547grbluser/FPGA-DENDY/PCB/Cyclone PCB/FPGA_DENDY.png

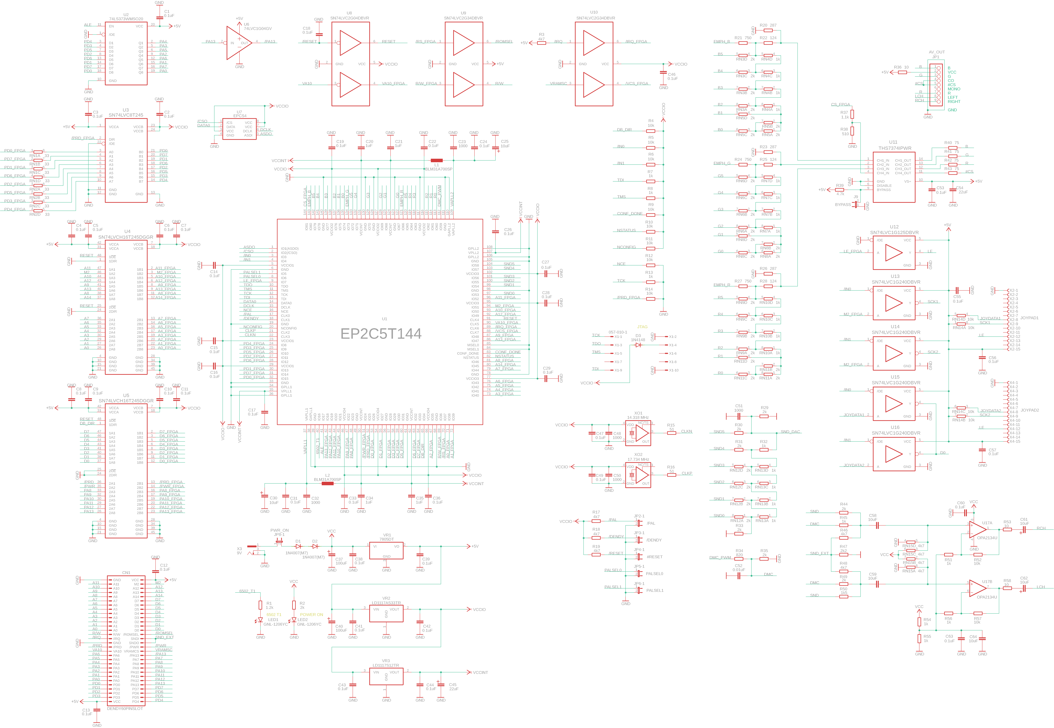
PCB/Cyclone PCB/FPGA_DENDY.png
