547grbluser/FPGA-DENDY/PCB/Lattice PCB/FPGA_DENDY_LAT.png

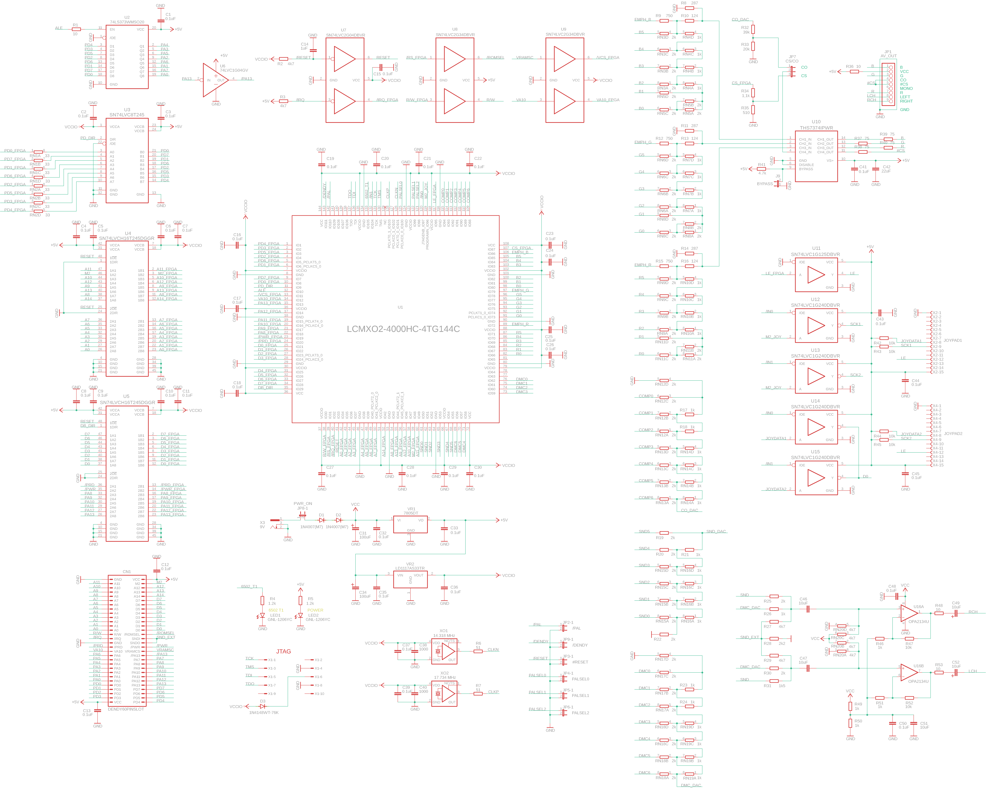
PCB/Lattice PCB/FPGA_DENDY_LAT.png
