547grbluser/FPGA-DENDY/PCB/Lattice PCB/BOM FPGA_DENDY LAT.xlsx

POS | Q-ty | VALUE | manufacturer | package | PART NUM | SIMILAR
 | 1 | LCMXO2-4000HC-4TG144I | Lattice Semiconductor | TQFP-144 | LCMXO2-4000HC-4TG144I | LCMXO2-4000HC-4TG144C
 | 1 | SN74LVC8T245PWR | TI | TSSOP-24 | SN74LVC8T245PWR | SN74LVC4245APWR
 | 2 | SN74LVCH16T245DGGR | TI | TSSOP-48 | SN74LVCH16T245DGGR
 | 1 | SN74LS373DW | TI | soic-20(7.5мм) | SN74LS373DW
 | 4 | SN74LVC1G240DBVR | TI | SOT-23-5 | SN74LVC1G240DBVR
 | 1 | SN74LVC1G125DBVR | TI | SOT-23-5 | SN74LVC1G125DBVR
 | 1 | SN74LVC1G04DBVR | TI | SOT-23-5 | SN74LVC1G04DBVR
 | 1 | SN74LVC2G04DBVR | TI | SOT-23-6 | SN74LVC2G04DBVR
 | 2 | SN74LVC2G34DBVR | TI | SOT-23-6 | SN74LVC2G34DBVR
 | 1 | BA4558F-E2 | Rohm | SOP-8 | BA4558F-E2
 | 1 | THS7374IPWR | TI | TSSOP-14 | THS7374IPWR
 | 1 | UMW 78M05 | UMW | DPAK/TO-252 | UMW 78M05
 | 1 | LD1117AS33TR | STM | SOT-223 | LD1117AS33TR
 | 1 | crystal oscillator 14.318MHz |  | 7050
 | 1 | crystal oscillator 17.734MHz |  | 7050
 | 2 | SMA4007 | UMW | DO-214AC/SMA | 1N4007(M7)
 | 1 | 1N4148W | EVVOSEMI | SOD - 123 | 1N4148W
 | 1 | GNL-1206YC | G-nor Electronics | 1206 | GNL-1206YC | any 1206 SMD LED (YELLOW)
 | 6 | 4х1kΩ1% | Bourns | 0603x4 | CAT16-102J4LF
 | 11 | 4х2kΩ1% | Bourns | 0603x4 | CAT16-202J4LF
 | 2 | 4х22Ω1% | Bourns | 0603x4 | CAT16-22R0F4LF
 | 1 | 4х4k7kΩ5% | Bourns | 0603x4 | CAT16-472J4LF
 | 4 | 75Ω±5% | YAGEO | 0603 | RC0603JR-0775RL
 | 2 | 51Ω±5% | YAGEO | 0603 | RC0603JR-0751RL
 | 4 | 10Ω±5% | YAGEO | 0603 | RC0603JR-0710RL
 | 2 | 1,2kΩ±5% | YAGEO | 0603 | RC0603JR-071K2L
 | 1 | 1,1kΩ±1% | YAGEO | 0603 | RC0603FR-071K1L
 | 1 | 510Ω±1% | YAGEO | 0603 | RC0603FR-07510RL
 | 3 | 750Ω±1% | KOA Speer | 0603 | RK73H1JTTD7500F
 | 9 | 1kΩ±1% | KOA Speer | 0603 | RK73G1JTTD1001F
 | 3 | 2kΩ±1% | KOA Speer | 0603 | RK73G1JTTD2001F
 | 1 | 20kΩ±1% | KOA Speer | 0603 | RK73H1JTTD2002F
 | 1 | 39kΩ±1% | KOA Speer | 0603 | RK73H1JTTD3902F
 | 6 | 4,7kΩ±5% | YAGEO | 0603 | RC0603JR-074K7L
 | 4 | 10kΩ±5% | YAGEO | 0603 | RC0603JR-0710KL
 | 3 | 124Ω±1% | Vishay/Dale | 0603 | CRCW0603124RFKEA
 | 3 | 287Ω±1% | KOA Speer | 0603 | RK73H1JTTD2870F
 | 41 | 0.1uF X7R 16V 10% | Murata | 0603 | GRM188R71C104KA01D
 | 2 | 1000pF NP0 50V 5% 0603 | Murata | 0603 | GRM1885C1H102J
 | 8 | 10uF X7R 10% 25V 1210, | Murata | 1210 | GRM32DR71E106KA12L
 | 2 | 100uF, 16v, 105°C, 20% ECAP SMD, 6.3x5.4мм, | JB cap | 6.3x5.4 | JCK1C101M063054
 | 1 | 9 Pin Mini DIN Female PCB Panel Mount | China
 | 1 | BH-10 (DS1013-10S) (IDC-10MS) | CONNFLY | 2*5*2.54 | DS1013-10SSiB1-B-0
 | 1 | KLS1-DC-005A-2.0 | KLS electronic co ltd | 2,1х5.5x9mm | L-KLS1-DC-005A-2.0
