547grbluser/FPGA-DENDY/PCB/Lattice PCB/FPGA_DENDY_LAT.sch

## EAGLE design PCB/Lattice PCB/FPGA_DENDY_LAT.sch (2026-10-07)

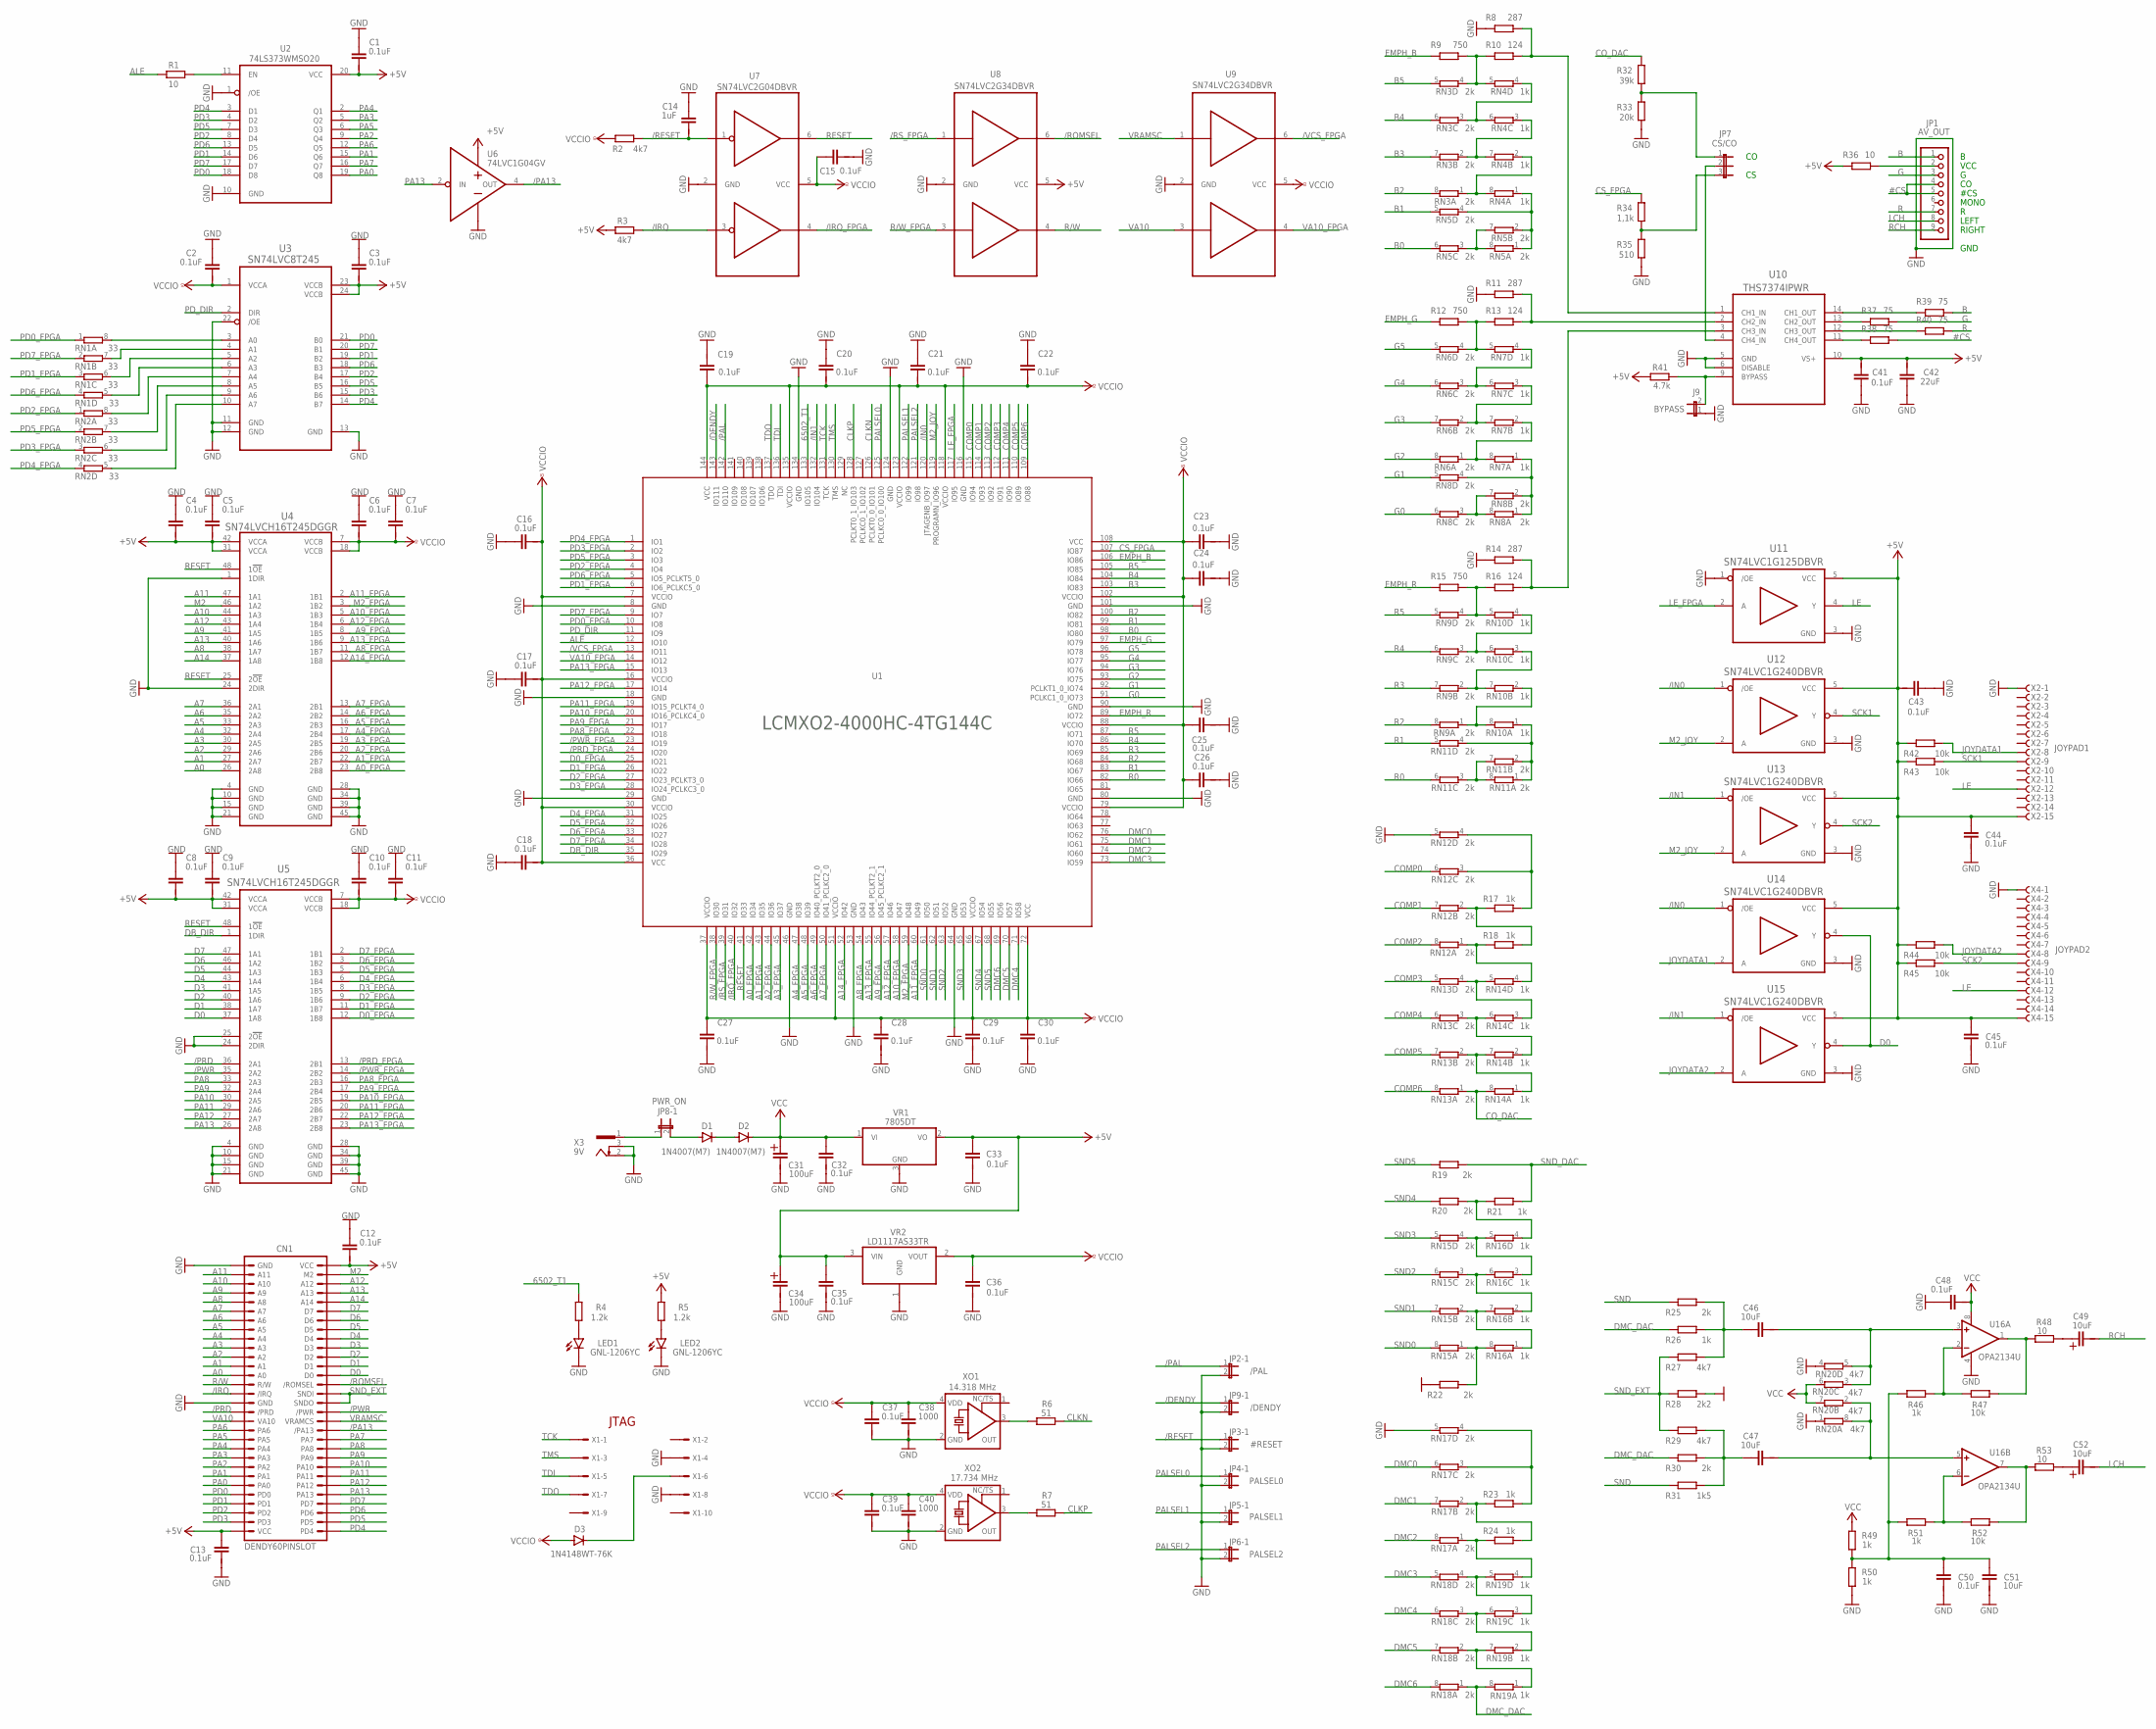
[picture p5: schematic FPGA_DENDY_LAT.sch]

Parts:
C1, C2, C3, C4, C5, C6, C7, C8, C9, C10, C11, C12, C13, C15, C16, C17, C18, C19, C20, C21, C22, C23, C24, C25, C26, C27, C28, C29, C30, C32, C33, C35, C36, C37, C39, C44, C45, C48, C50: 0.1uF; C0805
C14: 1uF; C0805
C31, C34: 100uF; 153CLV-0505
C38, C40: 1000; C0805
C41, C43: 0.1uF; C0603
C42: 22uF; C0603
C46, C47, C51: 10uF; C0805
C49, C52: 10uF; 153CLV-0505
CN1: DENDY60PINSLOT; 60PINDENDY
D1, D2: 1N4007(M7); DO-214AC
D3: 1N4148WT-76K; DO214AA
J9: BYPASS; JP1
JP1: AV_OUT; 1X09
JP2: /PAL; JP4Q
JP3: #RESET; JP4Q
JP4: PALSEL0; JP4Q
JP5: PALSEL1; JP4Q
JP6: PALSEL2; JP4Q
JP7: CS/CO; JP2W
JP8: PWR_ON; JP4Q
JP9: /DENDY; JP4Q
LED1, LED2: GNL-1206YC; SML1206
R1, R36, R48, R53: 10; R0805
R2, R3, R27, R29: 4k7; R0805
R4, R5: 1.2k; R0805
R6, R7: 51; R0805
R8, R11, R14: 287; R0805
R9, R12, R15: 750; R0805
R10, R13, R16: 124; R0805
R17, R18, R21, R23, R24, R26, R46, R49, R50, R51: 1k; R0805
R19, R20, R22, R25, R30: 2k; R0805
R28: 2k2; R0805
R31: 1k5; R0805
R32: 39k; R0805
R33: 20k; R0805
R34: 1,1k; R0805
R35: 510; R0805
R37, R38, R39, R40: 75; R0805
R41: 4.7k; R0805
R42, R43, R44, R45, R47, R52: 10k; R0805
RN1, RN2: 33; 0603-ARC
RN3, RN5, RN6, RN8, RN9, RN11, RN12, RN13, RN15, RN17, RN18: 2k; 0603-ARC
RN4, RN7, RN10, RN14, RN16, RN19: 1k; 0603-ARC
RN20: 4k7; 0603-ARC
U1: LCMXO2-4000HC-4TG144C; TQFP144
U2: 74LS373WMSO20; SO20W
U3: SN74LVC8T245; SOP65P640X110-24N
U4, U5: SN74LVCH16T245DGGR; SOP50P810X120-48N
U6: 74LVC1G04GV; SOT95P275X110-5N
U7: SN74LVC2G04DBVR; SOT-23-6
U8, U9: SN74LVC2G34DBVR; SOT-23-6
U10: THS7374IPWR; SOP65P640X120-14N
U11: SN74LVC1G125DBVR; SOT95P280X145-5N
U12, U13, U14, U15: SN74LVC1G240DBVR; SOT95P280X145-5N
U16: OPA2134U; SO08
VR1: 7805DT; TO252
VR2: LD1117AS33TR; SOT230P700X180-4N
X1: 057-010-1
X2: JOYPAD1; F15HP
X3: 9V; 733980-62
X4: JOYPAD2; F15HP
XO1: 14.318 MHz; 7.0X5.08_KXO-(V)97
XO2: 17.734 MHz; 2.5X2.0_KXO-V95

Connections:
6502_T1: R4.2, U1.133 (IO105)
#CS: JP1.4, JP1.5, R38.2
+5V: C1.2, C3.2, C4.2, C5.2, C8.2, C9.2, C12.2, C13.1, C33.1, C34.+, C35.1, C41.2, C42.2, C43.2, C44.1, C45.1, CN1.A30 (VCC), CN1.B1 (VCC), R3.1, R5.2, R36.1, R41.1, R42.1, R43.1, R44.1, R45.1, U2.20 (VCC), U3.23 (VCCB), U3.24 (VCCB), U4.31 (VCCA), U4.42 (VCCA), U5.31 (VCCA), U5.42 (VCCA), U6.5 (VCC), U8.5 (VCC), U10.10 (VS+), U11.5 (VCC), U12.5 (VCC), U13.5 (VCC), U14.5 (VCC), U15.5 (VCC), VR1.2 (VO), VR2.3 (VIN), X2.15 (F), X4.15 (F)
/DENDY: JP9.1, U1.143 (IO111)
/IN0: U1.120 (JTAGENB_IO97), U12.1 (/OE), U14.1 (/OE)
/IN1: U1.132 (IO104), U13.1 (/OE), U15.1 (/OE)
/IRQ: CN1.A15 (/IRQ), R3.2, U7.3 (IN2)
/IRQ_FPGA: U1.40 (IO32), U7.4 (OUT2)
/PA13: CN1.B19 (/PA13), U6.4 (OUT)
/PAL: JP2.1, U1.142 (IO110)
/PRD: CN1.A17 (/PRD), U5.36 (2A1)
/PRD_FPGA: U1.24 (IO20), U5.13 (2B1)
/PWR: CN1.B17 (/PWR), U5.35 (2A2)
/PWR_FPGA: U1.23 (IO19), U5.14 (2B2)
/RESET: C14.2, JP3.1, R2.2, U7.1 (IN1)
/ROMSEL: CN1.B14 (/ROMSEL), U8.6 (OUT1)
/RS_FPGA: U1.39 (IO31), U8.1 (IN1)
/VCS_FPGA: U1.13 (IO11), U9.6 (OUT1)
A0: CN1.A13 (A0), U4.26 (2A8)
A0_FPGA: U1.42 (IO34), U4.23 (2B8)
A1: CN1.A12 (A1), U4.27 (2A7)
A1_FPGA: U1.43 (IO35), U4.22 (2B7)
A2: CN1.A11 (A2), U4.29 (2A6)
A2_FPGA: U1.44 (IO36), U4.20 (2B6)
A3: CN1.A10 (A3), U4.30 (2A5)
A3_FPGA: U1.45 (IO37), U4.19 (2B5)
A4: CN1.A9 (A4), U4.32 (2A4)
A4_FPGA: U1.47 (IO38), U4.17 (2B4)
A5: CN1.A8 (A5), U4.33 (2A3)
A5_FPGA: U1.48 (IO39), U4.16 (2B3)
A6: CN1.A7 (A6), U4.35 (2A2)
A6_FPGA: U1.49 (IO40_PCLKT2_0), U4.14 (2B2)
A7: CN1.A6 (A7), U4.36 (2A1)
A7_FPGA: U1.50 (IO41_PCLKC2_0), U4.13 (2B1)
A8: CN1.A5 (A8), U4.38 (1A7)
A8_FPGA: U1.54 (IO43), U4.11 (1B7)
A9: CN1.A4 (A9), U4.41 (1A5)
A9_FPGA: U1.56 (IO45_PCLKC2_1), U4.8 (1B5)
A10: CN1.A3 (A10), U4.44 (1A3)
A10_FPGA: U1.58 (IO47), U4.5 (1B3)
A11: CN1.A2 (A11), U4.47 (1A1)
A11_FPGA: U1.60 (IO49), U4.2 (1B1)
A12: CN1.B3 (A12), U4.43 (1A4)
A12_FPGA: U1.57 (IO46), U4.6 (1B4)
A13: CN1.B4 (A13), U4.40 (1A6)
A13_FPGA: U1.55 (IO44_PCLKT2_1), U4.9 (1B6)
A14: CN1.B5 (A14), U4.37 (1A8)
A14_FPGA: U1.52 (IO42), U4.12 (1B8)
ALE: R1.1, U1.12 (IO10)
B: JP1.1, R39.2
B0: RN5.6 (2), U1.98 (IO80)
B1: RN5.5 (2), U1.99 (IO81)
B2: RN3.8 (2), U1.100 (IO82)
B3: RN3.7 (2), U1.103 (IO83)
B4: RN3.6 (2), U1.104 (IO84)
B5: RN3.5 (2), U1.105 (IO85)
CLKN: R6.2, U1.126 (PCLKT0_0_IO101)
CLKP: R7.2, U1.128 (PCLKT0_1_IO103)
COMP0: RN12.6 (2), U1.115 (IO94)
COMP1: RN12.7 (2), U1.114 (IO93)
COMP2: RN12.8 (2), U1.113 (IO92)
COMP3: RN13.5 (2), U1.112 (IO91)
COMP4: RN13.6 (2), U1.111 (IO90)
COMP5: RN13.7 (2), U1.110 (IO89)
COMP6: RN13.8 (2), U1.109 (IO88)
CO_DAC: R32.2, RN13.1, RN14.8 (2)
CS_FPGA: R34.2, U1.107 (IO87)
D0: CN1.B13 (D0), U5.37 (1A8), U14.4 (Y), U15.4 (Y)
D0_FPGA: U1.25 (IO21), U5.12 (1B8)
D1: CN1.B12 (D1), U5.38 (1A7)
D1_FPGA: U1.26 (IO22), U5.11 (1B7)
D2: CN1.B11 (D2), U5.40 (1A6)
D2_FPGA: U1.27 (IO23_PCLKT3_0), U5.9 (1B6)
D3: CN1.B10 (D3), U5.41 (1A5)
D3_FPGA: U1.28 (IO24_PCLKC3_0), U5.8 (1B5)
D4: CN1.B9 (D4), U5.43 (1A4)
D4_FPGA: U1.31 (IO25), U5.6 (1B4)
D5: CN1.B8 (D5), U5.44 (1A3)
D5_FPGA: U1.32 (IO26), U5.5 (1B3)
D6: CN1.B7 (D6), U5.46 (1A2)
D6_FPGA: U1.33 (IO27), U5.3 (1B2)
D7: CN1.B6 (D7), U5.47 (1A1)
D7_FPGA: U1.34 (IO28), U5.2 (1B1)
DB_DIR: U1.35 (IO29), U5.1 (1DIR)
DMC0: RN17.6 (2), U1.76 (IO62)
DMC1: RN17.7 (2), U1.75 (IO61)
DMC2: RN17.8 (2), U1.74 (IO60)
DMC3: RN18.5 (2), U1.73 (IO59)
DMC4: RN18.6 (2), U1.71 (IO58)
DMC5: RN18.7 (2), U1.70 (IO57)
DMC6: RN18.8 (2), U1.69 (IO56)
DMC_DAC: R26.1, R30.1, RN18.1, RN19.8 (2)
EMPH_B: R9.1, U1.106 (IO86)
EMPH_G: R12.1, U1.97 (IO79)
EMPH_R: R15.1, U1.89 (IO72)
G: JP1.3, R37.2
G0: RN8.6 (2), U1.91 (PCLKC1_0_IO73)
G1: RN8.5 (2), U1.92 (PCLKT1_0_IO74)
G2: RN6.8 (2), U1.93 (IO75)
G3: RN6.7 (2), U1.94 (IO76)
G4: RN6.6 (2), U1.95 (IO77)
G5: RN6.5 (2), U1.96 (IO78)
GND: C1.1, C2.1, C3.1, C4.1, C5.1, C6.1, C7.1, C8.1, C9.1, C10.1, C11.1, C12.1, C13.2, C14.1, C15.2, C16.1, C17.1, C18.1, C19.2, C20.1, C21.1, C22.1, C23.2, C24.2, C25.2, C26.2, C27.2, C28.2, C29.2, C30.2, C31.-, C32.2, C33.2, C34.-, C35.2, C36.2, C37.2, C38.2, C39.2, C40.2, C41.1, C42.1, C43.1, C44.2, C45.2, C48.1, C50.2, C51.2, CN1.A1 (GND), CN1.A16 (GND), J9.1, JP2.2, JP3.2, JP4.2, JP5.2, JP6.2, JP9.2, LED1.C, LED2.C, R8.1, R11.1, R14.1, R22.1, R28.2, R33.1, R35.1, R50.2, RN12.5 (2), RN17.5 (2), RN20.1, RN20.4 (1), U1.8 (GND), U1.18 (GND), U1.29 (GND), U1.46 (GND), U1.53 (GND), U1.64 (GND), U1.80 (GND), U1.90 (GND), U1.101 (GND), U1.116 (GND), U1.124 (GND), U1.134 (GND), U2.1 (/OE), U2.10 (GND), U3.11 (GND), U3.12 (GND), U3.13 (GND), U3.22 (/OE), U4.1 (1DIR), U4.4 (GND), U4.10 (GND), U4.15 (GND), U4.21 (GND), U4.24 (2DIR), U4.28 (GND), U4.34 (GND), U4.39 (GND), U4.45 (GND), U5.4 (GND), U5.10 (GND), U5.15 (GND), U5.21 (GND), U5.24 (2DIR), U5.25 (2!OE), U5.28 (GND), U5.34 (GND), U5.39 (GND), U5.45 (GND), U6.3 (GND), U7.2 (GND), U8.2 (GND), U9.2 (GND), U10.5 (GND), U10.6 (DISABLE), U11.1 (/OE), U11.3 (GND), U12.3 (GND), U13.3 (GND), U14.3 (GND), U15.3 (GND), U16.4 (V-), VR1.3 (GND), VR2.1 (GND), X1.4, X1.8, X2.1 (F), X3.2, X3.3, X4.1 (F), XO1.2 (GND), XO2.2 (GND)
JOYDATA1: R42.2, U14.2 (A), X2.8 (F)
JOYDATA2: R44.2, U15.2 (A), X4.8 (F)
LCH: C52.-, JP1.8
LE: U11.4 (Y), X2.12 (F), X4.12 (F)
LE_FPGA: U1.117 (IO95), U11.2 (A)
M2: CN1.B2 (M2), U4.46 (1A2)
M2_FPGA: U1.59 (IO48), U4.3 (1B2)
M2_JOY: U1.119 (PROGRAMN_IO96), U12.2 (A), U13.2 (A)
unnamed: C46.1, R25.2, R26.2, R27.2
unnamed: R7.1, XO2.3 (OUT)
unnamed: D3.C, X1.6
unnamed: C46.2, RN20.3 (1), RN20.5 (2), U16.3 (+IN)
unnamed: RN18.2 (1), RN19.1, RN19.7 (2)
unnamed: R6.1, XO1.3 (OUT)
unnamed: C47.2, RN20.2 (1), RN20.8 (2), U16.5 (+IN)
unnamed: R20.2, R21.1, RN16.4 (1)
unnamed: RN1.8 (2), U3.3 (A0)
unnamed: RN1.7 (2), U3.4 (A1)
unnamed: RN13.2 (1), RN14.1, RN14.7 (2)
unnamed: RN1.6 (2), U3.5 (A2)
unnamed: RN1.5 (2), U3.6 (A3)
unnamed: R9.2, R10.1, RN3.4 (1), RN4.5 (2)
unnamed: R51.2, R52.1, U16.6 (-IN)
unnamed: RN3.3 (1), RN4.4 (1), RN4.6 (2)
unnamed: RN2.8 (2), U3.7 (A4)
unnamed: RN3.2 (1), RN4.3 (1), RN4.7 (2)
unnamed: JP7.3, R34.1, R35.2
unnamed: RN13.3 (1), RN14.2 (1), RN14.6 (2)
unnamed: RN13.4 (1), RN14.3 (1), RN14.5 (2)
unnamed: R17.2, RN12.3 (1), RN12.4 (1)
unnamed: RN3.1, RN4.2 (1), RN4.8 (2)
unnamed: R12.2, R13.1, RN6.4 (1), RN7.5 (2)
unnamed: RN6.3 (1), RN7.4 (1), RN7.6 (2)
unnamed: RN6.2 (1), RN7.3 (1), RN7.7 (2)
unnamed: RN4.1, RN5.1, RN5.2 (1), RN5.4 (1)
unnamed: RN6.1, RN7.2 (1), RN7.8 (2)
unnamed: RN5.3 (1), RN5.7 (2), RN5.8 (2)
unnamed: C47.1, R29.2, R30.2, R31.2
unnamed: RN2.7 (2), U3.8 (A5)
unnamed: RN2.6 (2), U3.9 (A6)
unnamed: RN7.1, RN8.1, RN8.2 (1), RN8.4 (1)
unnamed: R15.2, R16.1, RN9.4 (1), RN10.5 (2)
unnamed: RN9.3 (1), RN10.4 (1), RN10.6 (2)
unnamed: RN8.3 (1), RN8.7 (2), RN8.8 (2)
unnamed: C49.+, R48.2
unnamed: R11.2, R13.2, U10.2 (CH2_IN)
unnamed: RN9.2 (1), RN10.3 (1), RN10.7 (2)
unnamed: RN9.1, RN10.2 (1), RN10.8 (2)
unnamed: RN10.1, RN11.1, RN11.2 (1), RN11.4 (1)
unnamed: R46.2, R47.1, U16.2 (-IN)
unnamed: R47.2, R48.1, U16.1 (OUT)
unnamed: R52.2, R53.1, U16.7 (OUT)
unnamed: C52.+, R53.2
unnamed: R18.1, RN12.1, RN14.4 (1)
unnamed: R17.1, R18.2, RN12.2 (1)
unnamed: JP7.1, R32.1, R33.2
unnamed: JP1.2, R36.2
unnamed: R1.2, U2.11 (EN)
unnamed: R14.2, R16.2, U10.3 (CH3_IN)
unnamed: LED1.A, R4.1
unnamed: RN15.4 (1), RN16.3 (1), RN16.5 (2)
unnamed: J9.2, R41.2, U10.9 (BYPASS)
unnamed: RN15.3 (1), RN16.2 (1), RN16.6 (2)
unnamed: R8.2, R10.2, U10.1 (CH1_IN)
unnamed: RN15.2 (1), RN16.1, RN16.7 (2)
unnamed: R22.2, RN15.1, RN16.8 (2)
unnamed: RN2.5 (2), U3.10 (A7)
unnamed: JP7.2, U10.4 (CH4_IN)
unnamed: LED2.A, R5.1
unnamed: R39.1, U10.14 (CH1_OUT)
unnamed: R37.1, U10.13 (CH2_OUT)
unnamed: R40.1, U10.12 (CH3_OUT)
unnamed: R38.1, U10.11 (CH4_OUT)
unnamed: RN18.3 (1), RN19.2 (1), RN19.6 (2)
unnamed: RN18.4 (1), RN19.3 (1), RN19.5 (2)
unnamed: R23.2, RN17.3 (1), RN17.4 (1)
unnamed: RN11.3 (1), RN11.7 (2), RN11.8 (2)
unnamed: R24.1, RN17.1, RN19.4 (1)
unnamed: R23.1, R24.2, RN17.2 (1)
unnamed: D1.A, JP8.2
unnamed: D1.C, D2.A
unnamed: JP8.1, X3.1
PA0: CN1.A25 (PA0), U2.19 (Q8)
PA1: CN1.A24 (PA1), U2.15 (Q6)
PA2: CN1.A23 (PA2), U2.9 (Q4)
PA3: CN1.A22 (PA3), U2.5 (Q2)
PA4: CN1.A21 (PA4), U2.2 (Q1)
PA5: CN1.A20 (PA5), U2.6 (Q3)
PA6: CN1.A19 (PA6), U2.12 (Q5)
PA7: CN1.B20 (PA7), U2.16 (Q7)
PA8: CN1.B21 (PA8), U5.33 (2A3)
PA8_FPGA: U1.22 (IO18), U5.16 (2B3)
PA9: CN1.B22 (PA9), U5.32 (2A4)
PA9_FPGA: U1.21 (IO17), U5.17 (2B4)
PA10: CN1.B23 (PA10), U5.30 (2A5)
PA10_FPGA: U1.20 (IO16_PCLKC4_0), U5.19 (2B5)
PA11: CN1.B24 (PA11), U5.29 (2A6)
PA11_FPGA: U1.19 (IO15_PCLKT4_0), U5.20 (2B6)
PA12: CN1.B25 (PA12), U5.27 (2A7)
PA12_FPGA: U1.17 (IO14), U5.22 (2B7)
PA13: CN1.B26 (PA13), U5.26 (2A8), U6.2 (IN)
PA13_FPGA: U1.15 (IO13), U5.23 (2B8)
PALSEL0: JP4.1, U1.125 (PCLKC0_0_IO100)
PALSEL1: JP5.1, U1.122 (IO99)
PALSEL2: JP6.1, U1.121 (IO98)
PD0: CN1.A26 (PD0), U2.18 (D8), U3.21 (B0)
PD0_FPGA: RN1.1, U1.10 (IO8)
PD1: CN1.A27 (PD1), U2.14 (D6), U3.19 (B2)
PD1_FPGA: RN1.3 (1), U1.6 (IO6_PCLKC5_0)
PD2: CN1.A28 (PD2), U2.8 (D4), U3.17 (B4)
PD2_FPGA: RN2.1, U1.4 (IO4)
PD3: CN1.A29 (PD3), U2.4 (D2), U3.15 (B6)
PD3_FPGA: RN2.3 (1), U1.2 (IO2)
PD4: CN1.B30 (PD4), U2.3 (D1), U3.14 (B7)
PD4_FPGA: RN2.4 (1), U1.1 (IO1)
PD5: CN1.B29 (PD5), U2.7 (D3), U3.16 (B5)
PD5_FPGA: RN2.2 (1), U1.3 (IO3)
PD6: CN1.B28 (PD6), U2.13 (D5), U3.18 (B3)
PD6_FPGA: RN1.4 (1), U1.5 (IO5_PCLKT5_0)
PD7: CN1.B27 (PD7), U2.17 (D7), U3.20 (B1)
PD7_FPGA: RN1.2 (1), U1.9 (IO7)
PD_DIR: U1.11 (IO9), U3.2 (DIR)
R: JP1.7, R40.2
R0: RN11.6 (2), U1.82 (IO66)
R1: RN11.5 (2), U1.83 (IO67)
R2: RN9.8 (2), U1.84 (IO68)
R3: RN9.7 (2), U1.85 (IO69)
R4: RN9.6 (2), U1.86 (IO70)
R5: RN9.5 (2), U1.87 (IO71)
R/W: CN1.A14 (R/W), U8.4 (OUT2)
R/W_FPGA: U1.38 (IO30), U8.3 (IN2)
RCH: C49.-, JP1.9
RESET: U1.41 (IO33), U4.25 (2!OE), U4.48 (1!OE), U5.48 (1!OE), U7.6 (OUT1)
SCK1: R43.2, U12.4 (Y), X2.9 (F)
SCK2: R45.2, U13.4 (Y), X4.9 (F)
SND: R25.1, R31.1
SND0: RN15.8 (2), U1.61 (IO50)
SND1: RN15.7 (2), U1.62 (IO51)
SND2: RN15.6 (2), U1.63 (IO52)
SND3: RN15.5 (2), U1.65 (IO53)
SND4: R20.1, U1.67 (IO54)
SND5: R19.1, U1.68 (IO55)
SND_DAC: R19.2, R21.2
SND_EXT: CN1.B15 (SNDI), CN1.B16 (SNDO), R27.1, R28.1, R29.1
TCK: U1.131 (TCK), X1.1
TDI: U1.136 (TDI), X1.5
TDO: U1.137 (TDO), X1.7
TMS: U1.130 (TMS), X1.3
VA10: CN1.A18 (VA10), U9.3 (IN2)
VA10_FPGA: U1.14 (IO12), U9.4 (OUT2)
VCC: C31.+, C32.1, C48.2, D2.C, R49.1, RN20.6 (2), RN20.7 (2), U16.8 (V+), VR1.1 (VI)
VCCIO: C2.2, C6.2, C7.2, C10.2, C11.2, C15.1, C16.2, C17.2, C18.2, C19.1, C20.2, C21.2, C22.2, C23.1, C24.1, C25.1, C26.1, C27.1, C28.1, C29.1, C30.1, C36.1, C37.1, C38.1, C39.1, C40.1, D3.A, R2.1, U1.7 (VCCIO), U1.16 (VCCIO), U1.30 (VCCIO), U1.36 (VCC), U1.37 (VCCIO), U1.51 (VCCIO), U1.66 (VCCIO), U1.72 (VCC), U1.79 (VCCIO), U1.88 (VCCIO), U1.102 (VCCIO), U1.108 (VCC), U1.118 (VCCIO), U1.123 (VCCIO), U1.135 (VCCIO), U1.144 (VCC), U3.1 (VCCA), U4.7 (VCCB), U4.18 (VCCB), U5.7 (VCCB), U5.18 (VCCB), U7.5 (VCC), U9.5 (VCC), VR2.2 (VOUT), XO1.4 (VDD), XO2.4 (VDD)
VPPL3: C50.1, C51.1, R46.1, R49.2, R50.1, R51.1
VRAMSC: CN1.B18 (VRAMCS), U9.1 (IN1)

Notes on the sheet:
GND
VCC
#CS
LEFT
RIGHT
MONO
JTAG
